AeroX2/epaper-smart-watch/README.md

# E-paper smart watch

- [Watch firmware](code/README.md)
- [Android companion](companion/README.md)
