AeroX2/epaper-smart-watch/case/et011tj1.FCStd

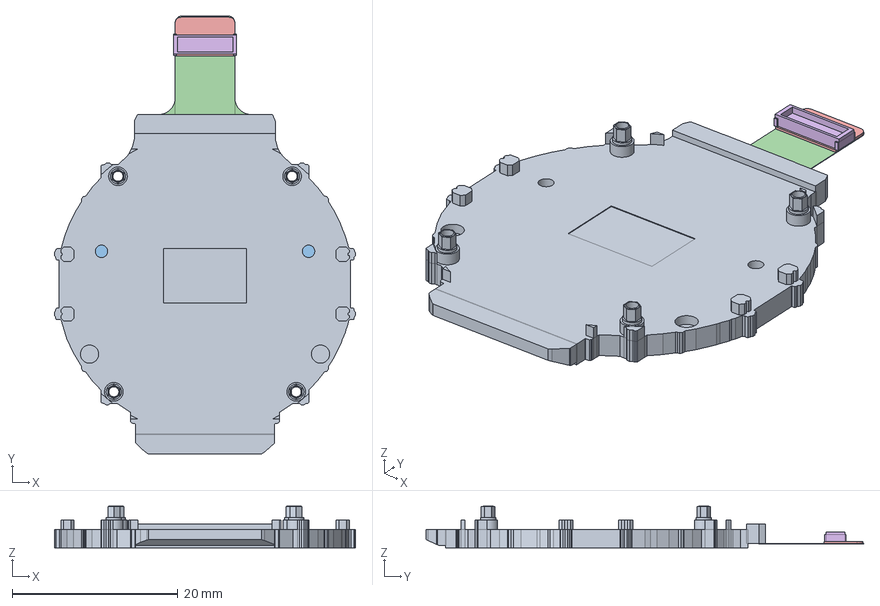
[picture p1: CAD file, 2026-09-06]
case/et011tj1.FCStd
36.3 x 52.8 x 5.05 mm
Case
DisplayMask
DisplayPanel
FPC
Stiffener
Connector
