AeroX2/epaper-smart-watch/pcb/case.FCStd

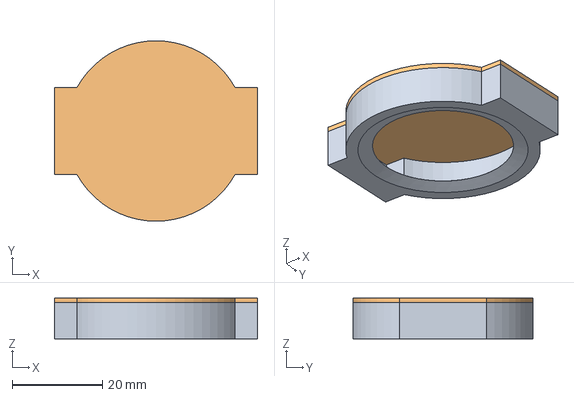
[picture p2: CAD file, 2026-08-02]
pcb/case.FCStd
45.0 x 40.0 x 9.00 mm
