AeroX2/epaper-smart-watch/case/case.FCStd

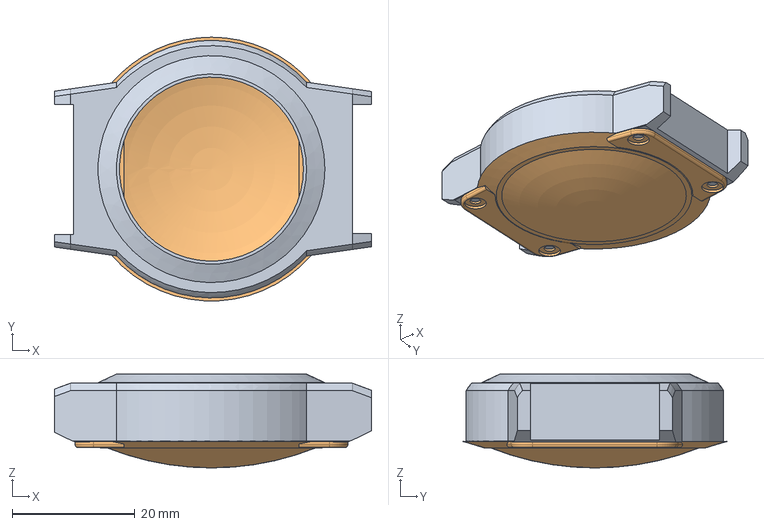
[picture p3: CAD file, 2026-09-06]
case/case.FCStd
51.7 x 43.0 x 15.3 mm
Main
