AeroX2/epaper-smart-watch/case/board.FCStd

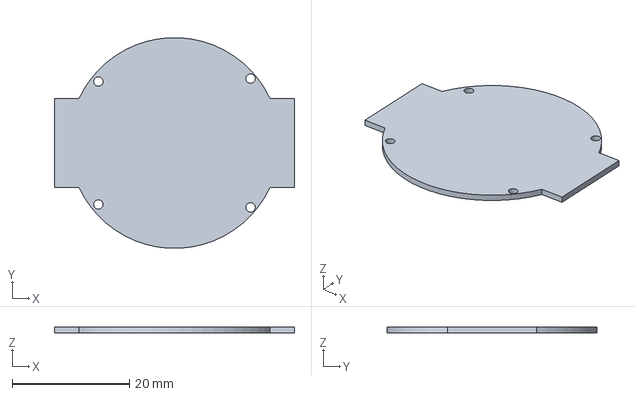
[picture p4: CAD file, 2026-07-12]
case/board.FCStd
41.0 x 35.9 x 1.00 mm
