AeroX2/epaper-smart-watch/(list of files, cad)

Other CAD files:
case/board.dxf
case/case.3mf
