AeroX2/epaper-smart-watch/pcb/epaper-smart-watch.kicad_pcb

## KiCad design pcb/epaper-smart-watch.kicad_pcb (2026-07-21)

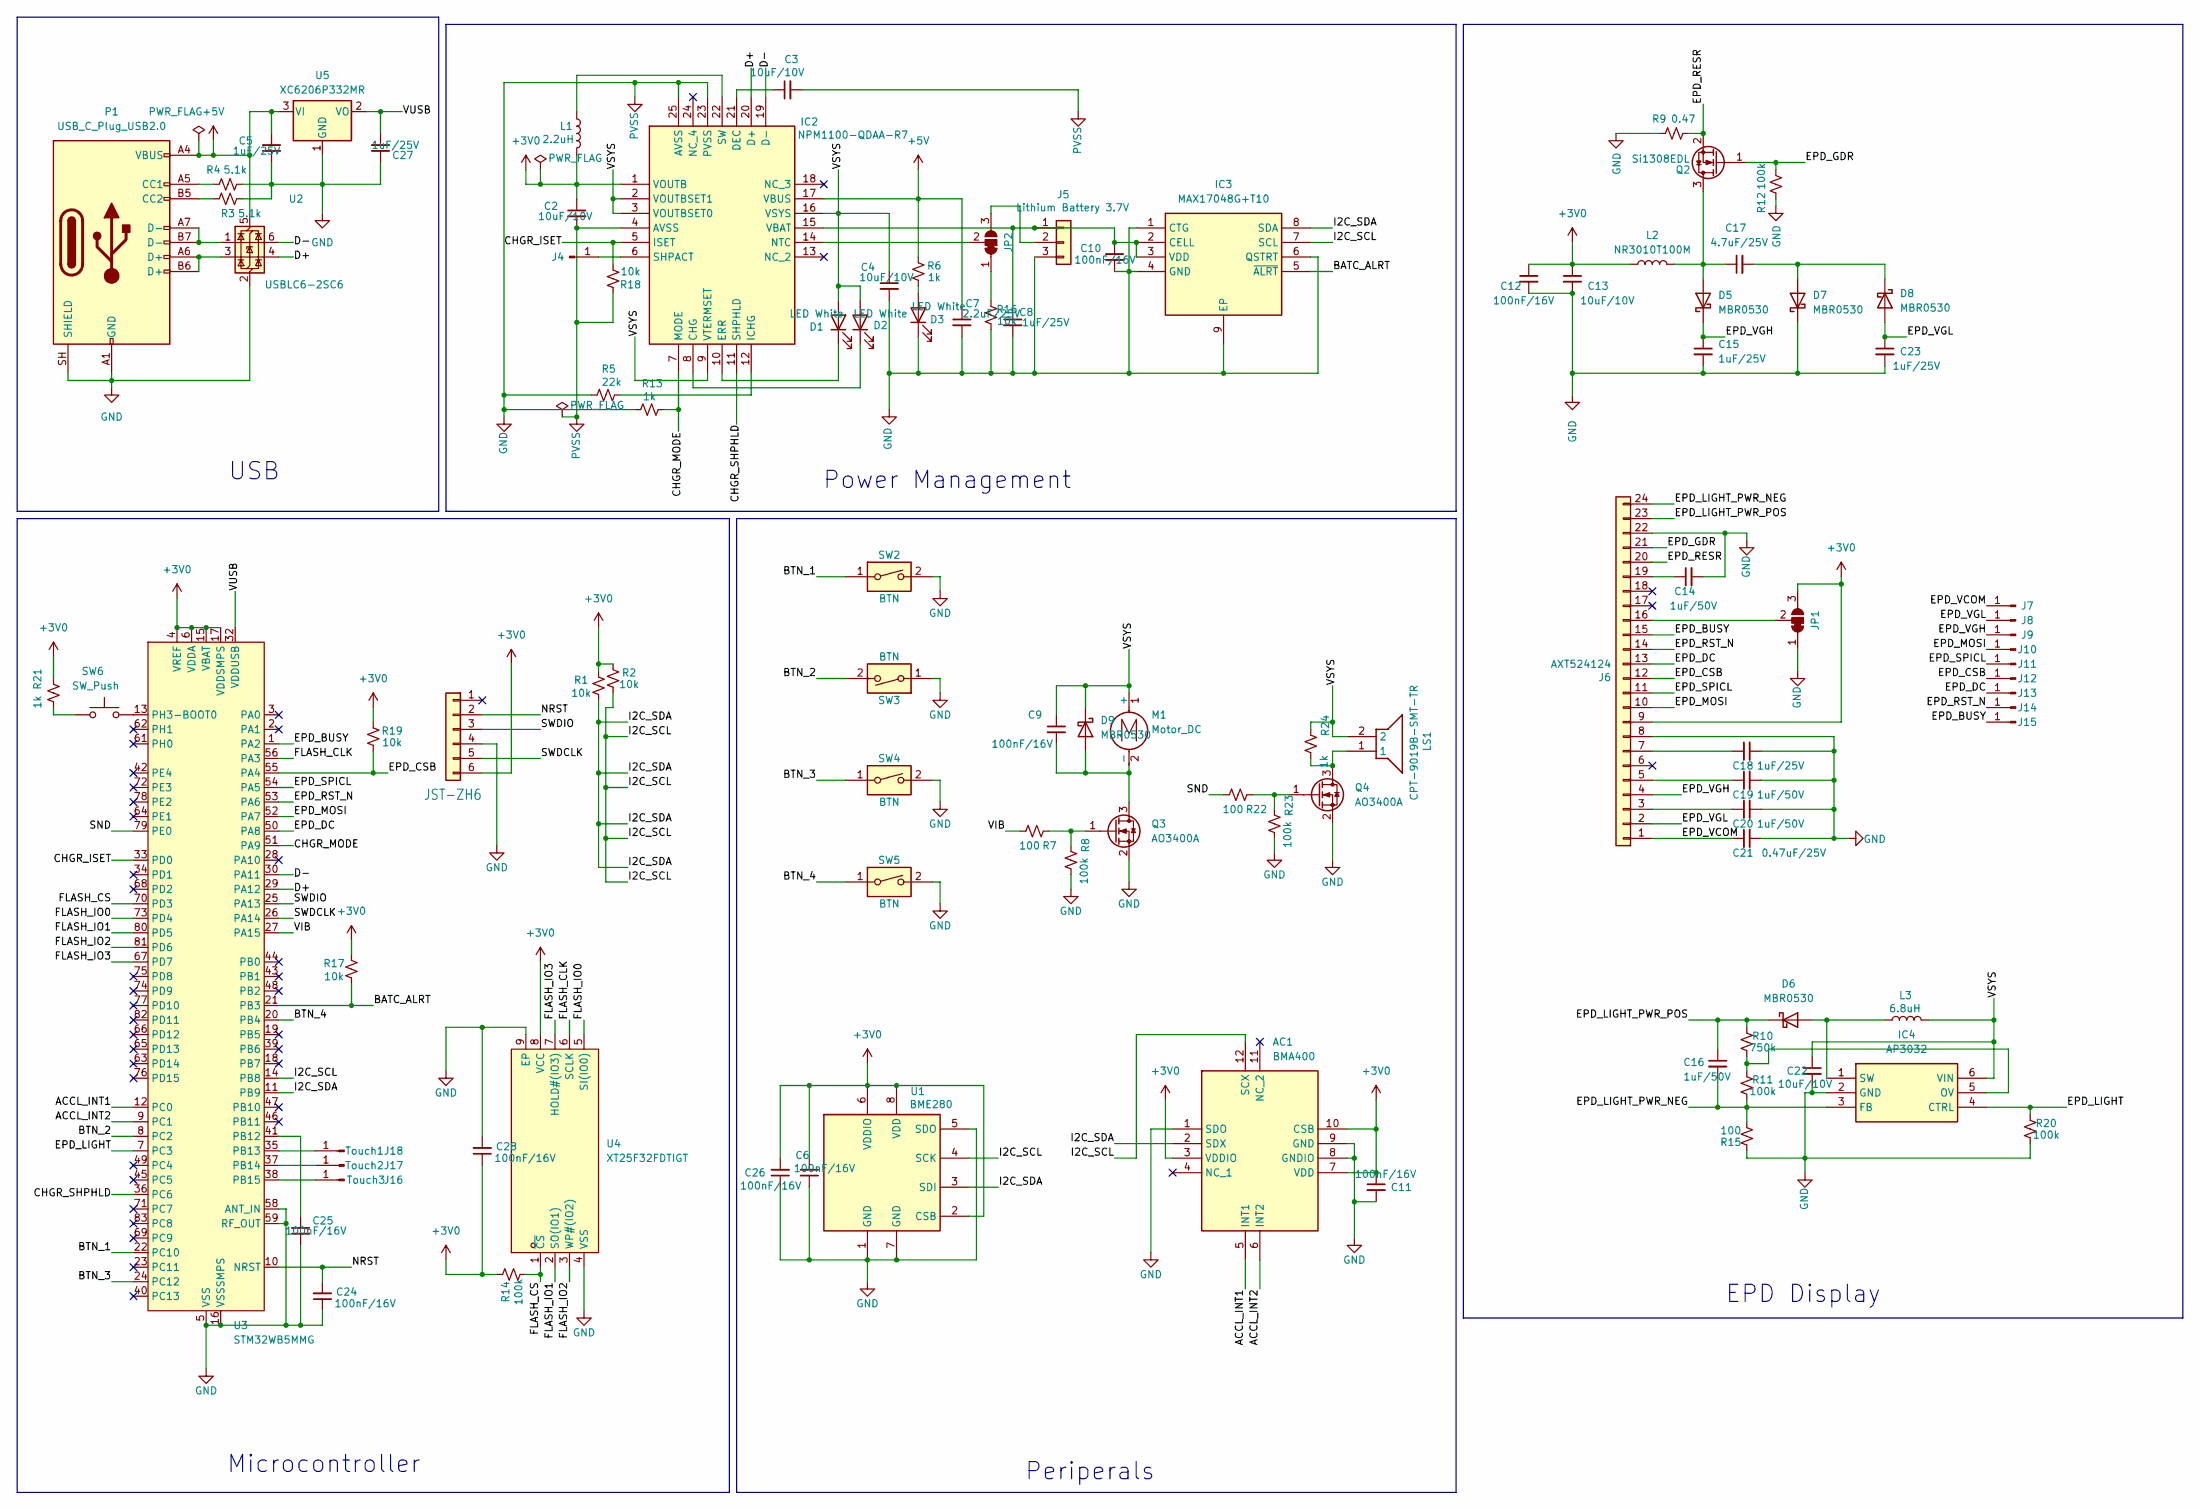
[picture p5: schematic epaper-smart-watch.kicad_sch, Epaper Smart Watch]

Parts:
AC1: BMA400; LGA-12_2x2mm_P0.5mm; Manufacturer_Part_Number BMA400; Mouser Part Number 262-BMA400
C2, C3, C4, C13, C22: 10uF/10V; C_0603_1608Metric; LCSC C19702
C5, C8, C18, C27: 1uF/25V; C_0402_1005Metric; LCSC C52923
C6, C9, C10, C11, C12, C24, C25, C26, C28: 100nF/16V; C_0402_1005Metric; LCSC C1525
C7: 2.2uF/25V; C_0805_2012Metric; LCSC C377773
C14, C16, C19, C20: 1uF/50V; C_0603_1608Metric; LCSC C15849
C15, C23: 1uF/25V; C_0805_2012Metric; LCSC C28323
C17: 4.7uF/25V; C_0805_2012Metric; LCSC C1779
C21: 0.47uF/25V; C_0603_1608Metric; LCSC C1623
D1, D2, D3: LED White; LED_0603_1608Metric; LCSC C2290
D5, D6, D7, D8, D9: MBR0530; D_SOD-123; LCSC C77336
IC2: NPM1100-QDAA-R7; QFN50P400X400X90-25N-D; Manufacturer_Part_Number NPM1100-QDAA-R7; Mouser Part Number 949-NPM1100-QDAA-R7
IC3: MAX17048G+T10; SON50P200X200X80-9N-D; Manufacturer_Part_Number MAX17048G+T10; Mouser Part Number 700-MAX17048G+T10
IC4: AP3032; SOT95P280X145-6N; Manufacturer_Part_Number AP3032; Mouser Part Number N/A
J4, J7, J8, J9, J10, J11, J12, J13, J14, J15: TestPoint_Pad_D1.0mm
J5: Lithium Battery 3.7V; SolderJumper-3_P1.3mm_Open_Pad1.0x1.5mm
J6: AXT524124; PANASONIC_AXT524124; LCSC C2859266
J16: Touch3; TestPoint_Pad_D1.0mm
J17: Touch2; TestPoint_Pad_D1.0mm
J18: Touch1; TestPoint_Pad_D1.0mm
JP1, JP2: SolderJumper_3_Bridged12; SolderJumper-3_P1.3mm_Bridged12_RoundedPad1.0x1.5mm_NumberL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
L1: 2.2uH; L_0603_1608Metric; LCSC C394950
L2: NR3010T100M; L_Taiyo-Yuden_NR-30xx; LCSC C6364771
L3: 6.8uH; L_0603_1608Metric; LCSC C50325627
LS1: CPT-9019B-SMT-TR; CPT9019SSMTTR; Manufacturer_Part_Number CPT-9019S-SMT-TR; Mouser Part Number 490-CPT-9019S-SMT-TR
M1: Motor_DC; SolderJumper-2_P1.3mm_Open_Pad1.0x1.5mm
P1: USB_C_Plug_USB2.0; USB-C-SMD_SHOU_TYPE-C-16P-CB1.6; LCSC C2906290
Q2: Si1308EDL; SOT-323_SC-70; LCSC C469327
Q3, Q4: AO3400A; SOT-23; LCSC C20917
R1, R2, R16, R17, R18, R19: 10k; R_0402_1005Metric; LCSC C25744
R3, R4: 5.1k; R_0402_1005Metric; LCSC C25905
R5: 22k; R_0402_1005Metric; LCSC C25768
R6, R13, R21, R24: 1k; R_0402_1005Metric; LCSC C11702
R7, R15, R22: 100; R_0402_1005Metric; LCSC C25076
R8, R11, R12, R14, R20, R23: 100k; R_0402_1005Metric; LCSC C25741
R9: 0.47; R_0402_1005Metric; LCSC C2090812
R10: 750k; R_0603_1608Metric; LCSC C23240
SW2, SW3, SW4, SW5: BTN; SW_SPST_B3U-3000P; LCSC C963349
SW6: SW_Push; SW_SPST_TS-1088-xR020; LCSC C720477
SWD1: JST-ZH6; JST_ZE_SM06B-ZESS-TB_1x06-1MP_P1.50mm_Horizontal; MPN S6B-ZR-SM4A-TF(LF)(SN); LCSC C5306612
U1: BME280; Bosch_LGA-8_2.5x2.5mm_P0.65mm_ClockwisePinNumbering; LCSC C92489
U2: USBLC6-2SC6; SOT-23-6; LCSC C7519
U3: STM32WB5MMG; ST-SiP-LGA-86-11x7.3mm; LCSC C5184586
U4: XT25F32FDTIGT; DFN-8_L3.0-W2.0-P0.50-BL-EP_XT25XXX; MPN XT25F32FDTIGT; LCSC C7429719
U5: XC6206P332MR; SOT-23-3; LCSC C5446

Connections:
+3V0: AC1.3 (VDDIO), AC1.7 (VDD), AC1.10 (CSB), C2.1, C6.2, C11.1, C12.1, C13.1, C26.2, C28.1, IC2.1 (VOUTB), J6.9, JP1.3 (B), L1.2, L2.1, R1.1, R2.1, R14.1, R17.1, R19.1, R21.1, SWD1.6, U1.2 (CSB), U1.6 (VDDIO), U1.8 (VDD), U3.4 (VREF), U3.6 (VDDA), U3.15 (VBAT), U3.17 (VDDSMPS), U4.8 (VCC)
+5V: C5.1, C7.1, IC2.17 (VBUS), P1.A4 (VBUS), P1.A9 (VBUS), P1.B4 (VBUS), P1.B9 (VBUS), R6.1, U2.5 (VBUS), U5.3 (VI)
/ACCL_INT1: AC1.5 (INT1), U3.12 (PC0)
/ACCL_INT2: AC1.6 (INT2), U3.9 (PC1)
/BATC_ALRT: IC3.5 (~ALRT), R17.2, U3.21 (PB3)
/BTN_1: SW2.1, U3.22 (PC10)
/BTN_2: SW3.2, U3.8 (PC2)
/BTN_3: SW4.1, U3.24 (PC12)
/BTN_4: SW5.1, U3.20 (PB4)
/CHGR_ISET: IC2.5 (ISET), R18.2, U3.33 (PD0)
/CHGR_MODE: IC2.7 (MODE), R13.2, U3.51 (PA9)
/CHGR_SHPHLD: IC2.11 (SHPHLD), U3.36 (PC6)
/D+: IC2.20 (D+), U2.4 (I/O2), U3.29 (PA12)
/D-: IC2.19 (D-), U2.6 (I/O1), U3.30 (PA11)
/EPD_BUSY: J6.15, J15.1 (Pin_1_1), U3.1 (PA2)
/EPD_CSB: J6.12, J12.1 (Pin_1_1), R19.2, U3.55 (PA4)
/EPD_DC: J6.13, J13.1 (Pin_1_1), U3.50 (PA8)
/EPD_GDR: J6.21, Q2.1 (G), R12.2
/EPD_LIGHT: IC4.4 (CTRL), R20.1, U3.7 (PC3)
/EPD_LIGHT_PWR_NEG: C16.2, IC4.3 (FB), J6.24, R11.2, R15.2
/EPD_LIGHT_PWR_POS: C16.1, D6.1 (K), J6.23, R10.1
/EPD_MOSI: J6.10, J10.1 (Pin_1_1), U3.52 (PA7)
/EPD_RESR: J6.20, Q2.2 (S), R9.2
/EPD_RST_N: J6.14, J14.1 (Pin_1_1), U3.53 (PA6)
/EPD_SPICL: J6.11, J11.1 (Pin_1_1), U3.54 (PA5)
/EPD_VCOM: C21.1, J6.1, J7.1 (Pin_1_1)
/EPD_VGH: C15.1, D5.1 (K), J6.4, J9.1 (Pin_1_1)
/EPD_VGL: C23.1, D8.2 (A), J6.2, J8.1 (Pin_1_1)
/FLASH_CLK: U3.56 (PA3), U4.6 (SCLK)
/FLASH_CS: R14.2, U3.70 (PD3), U4.1 (~CS)
/FLASH_IO0: U3.73 (PD4), U4.5 (SI(IO0))
/FLASH_IO1: U3.80 (PD5), U4.2 (SO(IO1))
/FLASH_IO2: U3.81 (PD6), U4.3 (WP#(IO2))
/FLASH_IO3: U3.67 (PD7), U4.7 (HOLD#(IO3))
/I2C_SCL: AC1.12 (SCX), IC3.7 (SCL), R2.2, U1.4 (SCK), U3.14 (PB8)
/I2C_SDA: AC1.2 (SDX), IC3.8 (SDA), R1.2, U1.3 (SDI), U3.11 (PB9)
/NRST: C24.2, SWD1.2, U3.10 (NRST)
/SND: R22.2, U3.79 (PE0)
/SWDCLK: SWD1.5, U3.26 (PA14)
/SWDIO: SWD1.3, U3.25 (PA13)
/VIB: R7.2, U3.27 (PA15)
/VSYS: C4.1, C9.1, C22.1, D1.2 (A), D2.2 (A), D9.1 (K), IC2.2 (VOUTBSET1), IC2.3 (VOUTBSET0), IC2.9 (VTERMSET), IC2.16 (VSYS), IC4.6 (VIN), L3.2, LS1.2, M1.1 (+), R24.1
/VUSB: C27.2, U3.32 (VDDUSB), U5.2 (VO)
GND: AC1.1 (SDO), AC1.8 (GNDIO), AC1.9 (GND), C2.2, C3.2, C4.2, C5.2, C6.1, C7.2, C8.2, C10.2, C11.2, C12.2, C13.2, C14.2, C15.2, C18.2, C19.2, C20.2, C21.2, C22.2, C23.2, C24.1, C25.2, C26.1, C27.1, C28.2, D3.1 (K), D7.1 (K), IC2.4 (AVSS), IC2.23 (PVSS), IC2.25 (AVSS), IC3.1 (CTG), IC3.4 (GND), IC3.6 (QSTRT), IC3.9 (EP), IC4.2 (GND), J5.3, J6.8, J6.22, JP1.1 (A), P1.A1 (GND), P1.A12 (GND), P1.B1 (GND), P1.B12 (GND), P1.SH (SHIELD), Q3.2 (S), Q4.2 (S), R3.1, R4.1, R5.1, R8.2, R9.1, R12.1, R13.1, R15.1, R16.2, R18.1, R20.2, R23.2, SW2.2, SW3.1, SW4.2, SW5.2, SWD1.4, U1.1 (GND), U1.5 (SDO), U1.7 (GND), U2.2 (GND), U3.5 (VSS), U3.16 (VSSSMPS), U3.31 (VSS), U3.57 (VSS), U3.58 (ANT_IN), U3.59 (RF_OUT), U3.60 (VSS), U3.84 (VSS), U3.86 (VSS), U4.4 (VSS), U4.9 (EP), U5.1 (GND)
unnamed: D1.1 (K), IC2.10 (ERR)
unnamed: D2.1 (K), IC2.8 (CHG)
unnamed: D3.2 (A), R6.2
unnamed: C17.1, D5.2 (A), L2.2, Q2.3 (D)
unnamed: D6.2 (A), IC4.1 (SW), L3.1
unnamed: C17.2, D7.2 (A), D8.1 (K)
unnamed: C9.2, D9.2 (A), M1.2 (-), Q3.3 (D)
unnamed: C3.1, IC2.21 (DEC)
unnamed: IC2.12 (ICHG), R5.2
unnamed: IC2.14 (NTC), JP2.2 (C)
unnamed: IC2.6 (SHPACT), J4.1 (Pin_1_1)
unnamed: IC2.22 (SW), L1.1
unnamed: C8.1, C10.1, IC2.15 (VBAT), IC3.2 (CELL), IC3.3 (VDD), J5.1
unnamed: IC4.5 (OV), R10.2, R11.1
unnamed: J5.2, JP2.3 (B)
unnamed: C20.1, J6.3
unnamed: C19.1, J6.5
unnamed: C18.1, J6.7
unnamed: J6.16, JP1.2 (C)
unnamed: C14.1, J6.19
unnamed: J16.1 (Pin_1_1), U3.38 (PB15)
unnamed: J17.1 (Pin_1_1), U3.37 (PB14)
unnamed: J18.1 (Pin_1_1), U3.35 (PB13)
unnamed: JP2.1 (A), R16.1
unnamed: P1.A5 (CC1), R4.2
unnamed: P1.B5 (CC2), R3.2
unnamed: P1.A6 (D+), P1.B6 (D+), U2.3 (I/O2)
unnamed: P1.A7 (D-), P1.B7 (D-), U2.1 (I/O1)
unnamed: Q3.1 (G), R7.1, R8.1
unnamed: LS1.1, Q4.3 (D), R24.2
unnamed: Q4.1 (G), R22.1, R23.1
unnamed: R21.2, SW6.1
unnamed: C25.1, U3.41 (PB12)
unnamed: SW6.2, U3.13 (PH3-BOOT0)

Notes on the sheet:
USB
Power Management
EPD Display
Periperals
Microcontroller

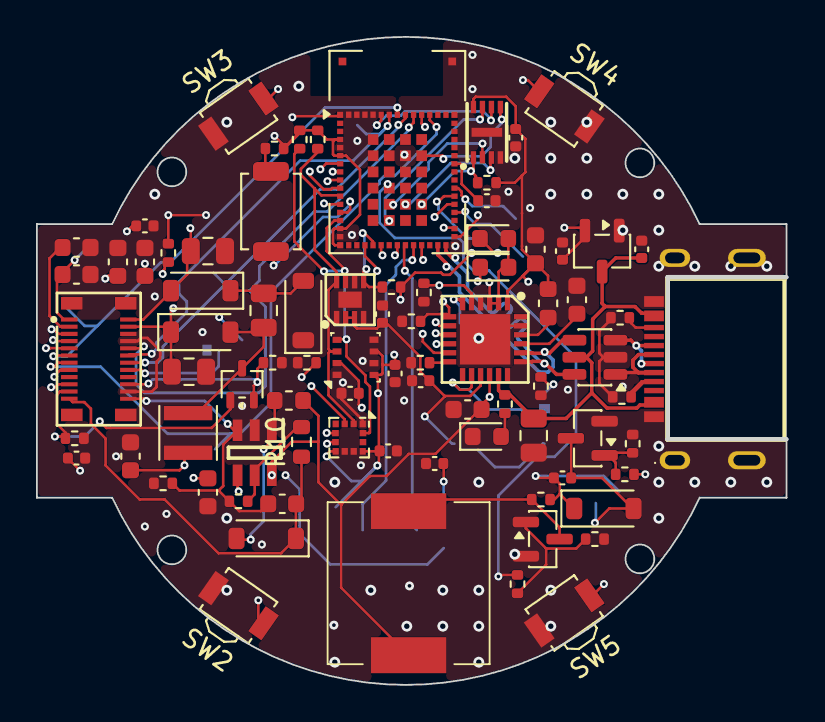
[picture p6: board epaper-smart-watch.kicad_pcb from above]

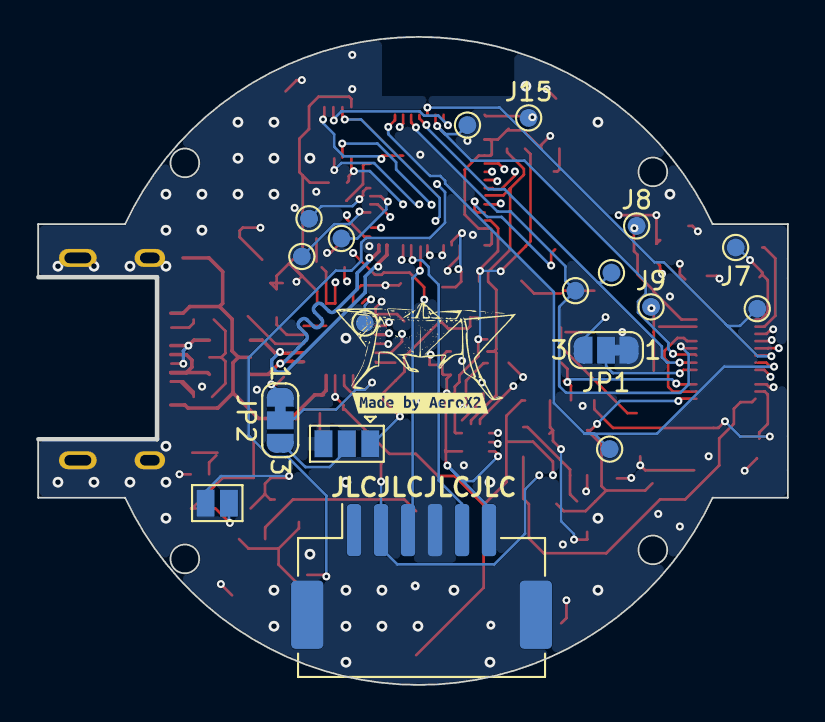
[picture p7: board epaper-smart-watch.kicad_pcb from below]

Board: 4 copper layers, 41.6 x 36.0 mm, 101 parts (19 on the bottom side), 78 nets.

Other parts of the board:
kibuzzard-6782824E: G***; kibuzzard-6782824E
