AeroX2/epaper-smart-watch/(commit log)

2024-11-09 Rename files
    [epaper-smart-watch.kicad_pcb, epaper-smart-watch.kicad_sch]
2024-11-11 Thickened power traces, fixed JP3 and removed pulldowns for buttons
    [epaper-smart-watch.kicad_pcb, epaper-smart-watch.kicad_sch]
2025-02-15 Use different accelerometer
    [epaper-smart-watch.kicad_pcb]
2026-06-17 Add ET011TJ1 e-paper display driver and bring-up firmware
    New SPI driver (code/lib/ET011TJ1) for the 1.1in 240x240 2-grey-level panel. main.cpp runs gradient/checkerboard/border full-refresh and partial-update test patterns over Serial1 (PA9/PA10). platformio.ini: serial upload via COM4 with RTS; generic.json: fix openocd target stm32wb1 -> stm32wbx.
    [main.cpp]
2026-06-17 Migrate KiCad project to v9 (format re-save + new DRC rules)
    Schematic/PCB/project files re-saved by KiCad 9 (file format 8.0 -> 9.0). Adds new DRC rules (creepage, hole_to_hole, track_angle, track_segment_length, text_on_edge_cuts). No schematic or layout design changes; respin fixes not yet applied.
    [epaper-smart-watch.kicad_pcb, epaper-smart-watch.kicad_sch]
2026-06-17 Add consolidated project summary and respin ECO
    Single-file reference combining hardware-debug findings, MCU/accelerometer/PMIC selection, battery-life analysis, and the full schematic respin change-list (formerly RESPIN_FIXES.md, now Part II). Supersedes the separate summary and respin docs.
2026-06-17 Ignore KiCad lock files; remove stray committed lock file
    Add *.lck and ~* to .gitignore (KiCad session-lock / tilde temp files) and drop the accidentally-committed ~epaper-smart-watch.kicad_sch.lck.
2026-06-21 V2 soon...
    [board.3mf, board.FCStd, board.dxf, epaper-smart-watch.kicad_pcb, epaper-smart-watch.kicad_sch]
2026-06-21 Add headless PCB auto-layout / auto-route tooling
    From-scratch pipeline driving KiCad 10 pcbnew + Freerouting:
    - place4.py: hierarchical cluster placer (each IC + its passives as a
    logical group; courtyard-aware, top/bottom-separate, schematic-weighted,
    edge-margin + RF keepout, respects locked parts). 0 overlaps, 0 edge
    violations, all parts placed.
    - check_courtyards.py / measure_*.py: courtyard-overlap, edge-clearance and
    cluster-cohesion verifiers.
    - dsn_export.py / ses_import.py: custom Specctra DSN export + Freerouting SES
    import (the built-in pcbnew variants hang headless).
    - probe_sides.py, pdftxt.py: helpers.
    - scratch/: one-off analysis/debug scripts kept for completenes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
2026-06-21 Stop tracking PDFs; ignore *.pdf
    Add *.pdf to .gitignore and git rm --cached all tracked PDFs (datasheets,
    schematic.pdf, gerber drill maps, and the example renders). Local copies are
    kept on disk; they're just no longer tracked in the repo.
2026-07-06 Add co-opt auto-routed board (52/76 nets, zero routing DRC)
    Generated by the pcb-auto-layout-route co-optimizing engine: placement from
    the saved xyz arrangement + grouping, back-side service parts parked at even
    board-rim slots, octilinear routing at 0.1mm with JLCPCB fab-rule floors.
    The .kicad_pro copy (matching stem) makes the real net classes load when
    opening this board directly; refill zones (B) before running DRC.
    [epaper-smart-watch-coopt.kicad_pcb]
2026-07-12 Routed the board, will do verification check soon
    [board.FCStd, epaper-smart-watch.kicad_pcb, epaper-smart-watch.kicad_sch]
2026-07-14 Routed board
    [epaper-smart-watch.kicad_pcb, epaper-smart-watch.kicad_sch]
2026-07-19 Final production V2 ready
    [epaper-smart-watch-CuBottom.gbr, epaper-smart-watch-CuIn1.gbr, epaper-smart-watch-CuIn2.gbr, epaper-smart-watch-CuTop.gbr, epaper-smart-watch-EdgeCuts.gbr, epaper-smart-watch-MaskBottom.gbr, epaper-smart-watch-MaskTop.gbr, epaper-smart-watch-NPTH.drl]
2026-07-21 V2 design as sent to fabrication
    - Swap 10k resistors (R1/R2/R16-R19) to JLCPCB basic part C25744
    (UNI-ROYAL) in the parts db, replacing extended FOJAN C2906861
    - Regenerate gerbers and production files from the final board
    - Add Panasonic AXT524124 24-pin FPC footprint and 3D model,
    remove the old AXT624124 footprint
    - Remove auto-layout tooling and the coopt-routed board variant
    - Ignore KiCad DRC/ERC .rpt report files
    Pre-order verification: ERC/DRC clean (warnings all cosmetic/known),
    0 unconnected, 0 schematic-parity issues; sch/board/BOM/CPL/parts-db
    cross-check clean; inductors verified against nPM1100, EPD boost
    reference, and AP3032 requirements.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
    [epaper-smart-watch-CuBottom.gbr, epaper-smart-watch-CuIn1.gbr, epaper-smart-watch-CuIn2.gbr, epaper-smart-watch-CuTop.gbr, epaper-smart-watch-EdgeCuts.gbr, epaper-smart-watch-MaskBottom.gbr, epaper-smart-watch-MaskTop.gbr, epaper-smart-watch-NPTH.drl]
2026-07-30 feat: add STM32WB5MMG peripheral bring-up firmware
2026-07-31 chore: organize enclosure design files
    [board.3mf, board.FCStd, board.dxf, case.3mf, case.FCStd]
2026-08-01 feat(updater): add resident STM32 USB DFU
2026-08-01 chore: remove obsolete planning and UI prototype
2026-08-01 feat(case): update enclosure model and pocket export
    [case-BodyPocket004.3mf, case.FCStd]
2026-08-02 feat(case): sync latest enclosure models
    [case.FCStd]
2026-08-04 feat(cad): keep editable FreeCAD model sources
    [ET011TJ1.FCStd, case-BodyPocket004.3mf, case.FCStd]
2026-09-06 Update case
    [ET011TJ1.FCStd, board.3mf, case.3mf, case.FCStd, et011tj1.FCStd]
